jonahp1/ElectronicWindMachine/Schematic-v1.png

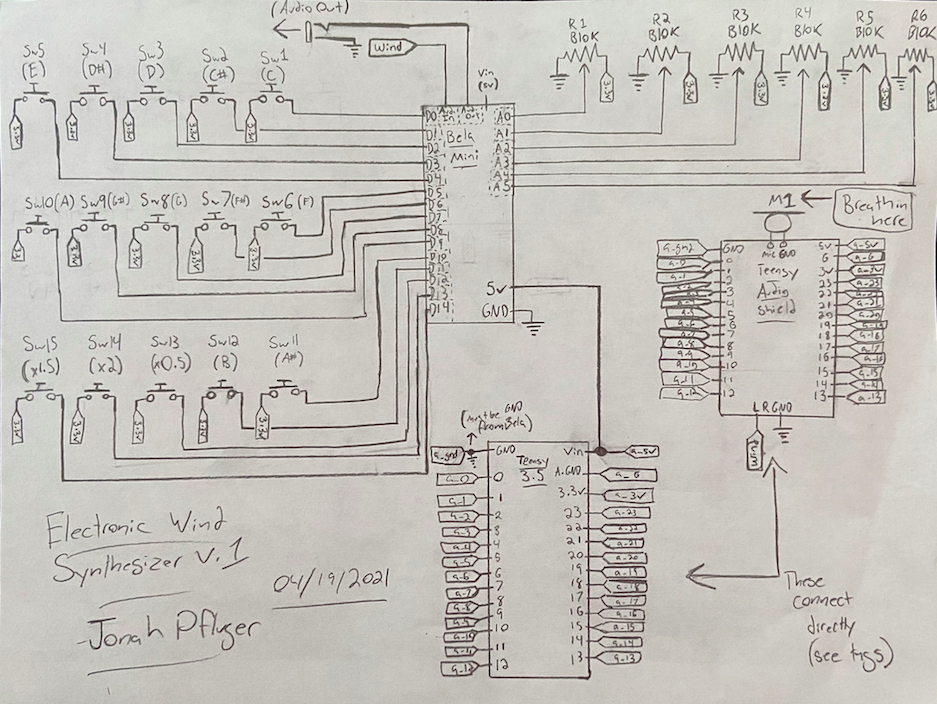
Schematic-v1.png
