jonahp1/ElectronicWindMachine/Presentation.pdf

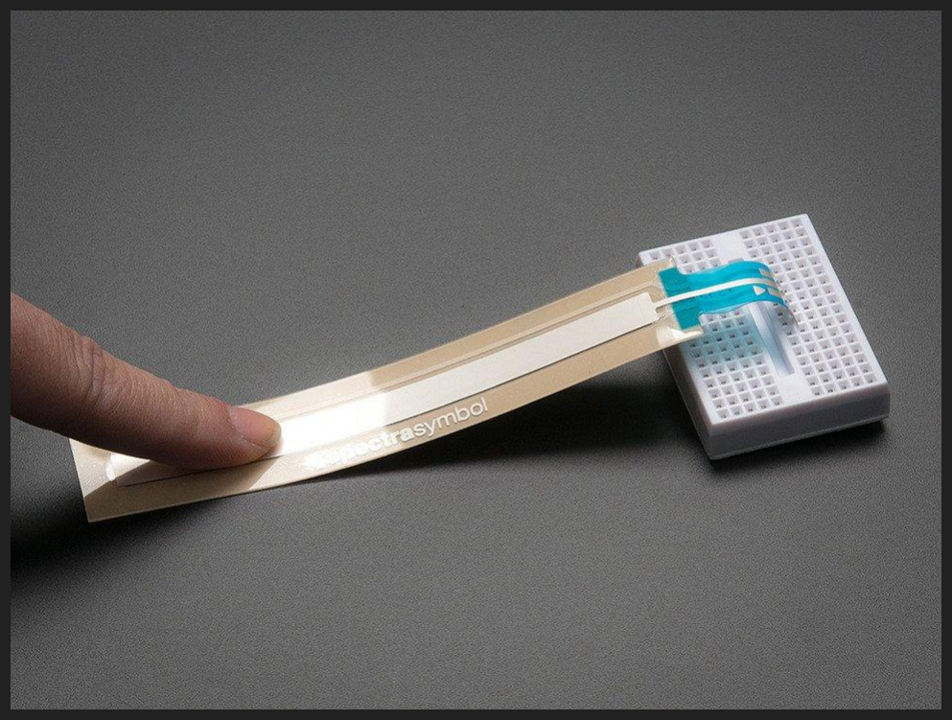
[picture p8: figure]
